sahasra247/RISCVMamba/docs/README.md

# docs/

Project documentation, interface specifications, reports, and architecture diagrams.  
**Owner:** E (Documentation & Coordination).

## Files in this Directory

| File | Purpose |
| --- | --- |
| `cfu_handshake_summary.md` | CPU-to-CFU interface handshake timing, pinout descriptions, stall behavior, and multi-cycle execution patterns. |
| `run_token_plan.pdf` | Architectural design report and bring-up plan for the single-token recurrent pipeline on CFU Playground. |
