sahasra247/RISCVMamba/results/spike_instr_counts_d256_l4.csv

kernel | baseline | +MAC | +MAC+NL | Xmamba
embed | 1813 | 1813 | 1813 | 1813
rmsnorm | 38007 | 38007 | 38007 | 38007
in_proj | 5141005 | 1655293 | 1655293 | 1655293
conv1d+silu | 192692 | 192692 | 100456 | 100456
x_proj | 547914 | 223802 | 223802 | 223802
dt_proj | 243774 | 88817 | 88817 | 88817
softplus | 327768 | 327768 | 14384 | 14384
scan | 3991110 | 3991110 | 1626336 | 16980
gate silu(z) | 105584 | 105584 | 32820 | 32820
out_proj | 2600445 | 871917 | 871917 | 871917
residual | 12332 | 12332 | 12332 | 12332
final norm+head | 337853 | 119993 | 119993 | 119993
total | 13541056 | 7629887 | 4786727 | 3177371
