sahasra247/RISCVMamba/hw/results/mamba_kernel_cycles.png

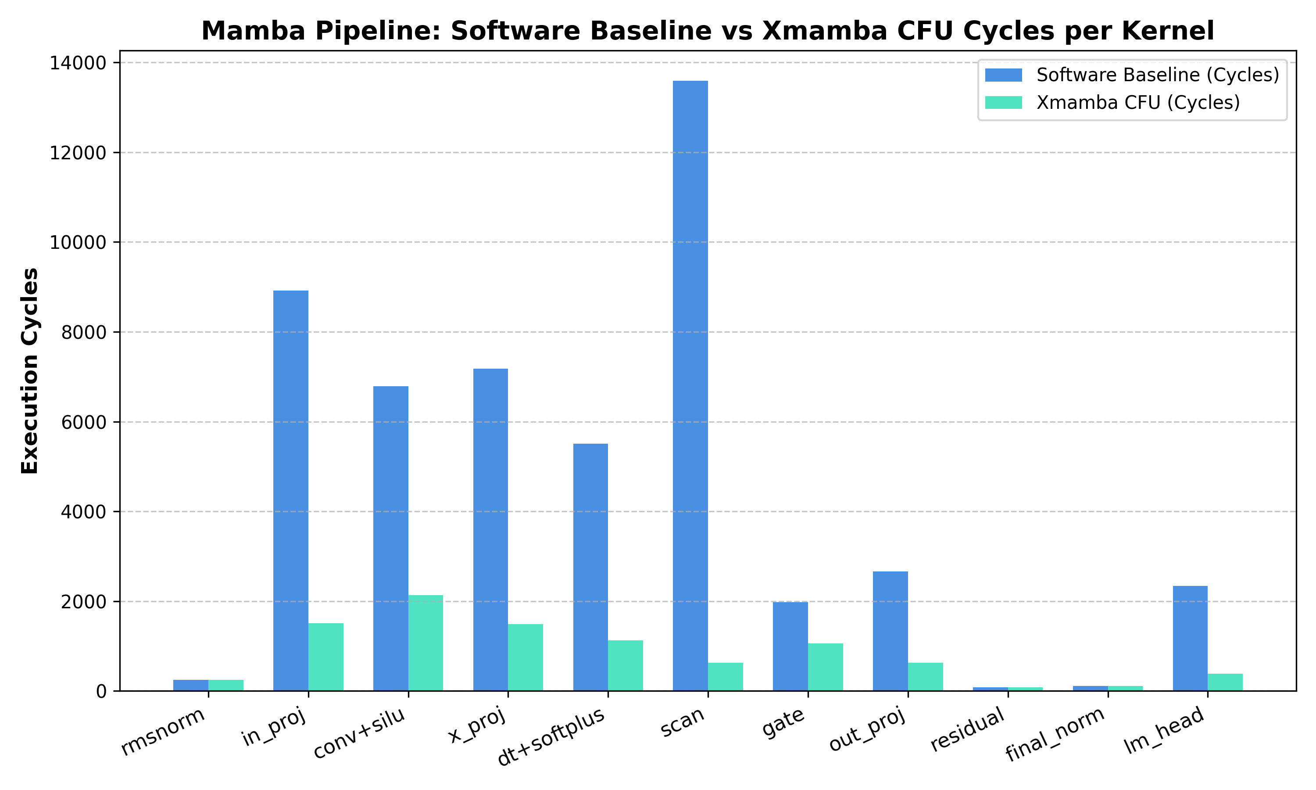
hw/results/mamba_kernel_cycles.png
