sahasra247/RISCVMamba/hw/results/mamba_kernel_speedup.png

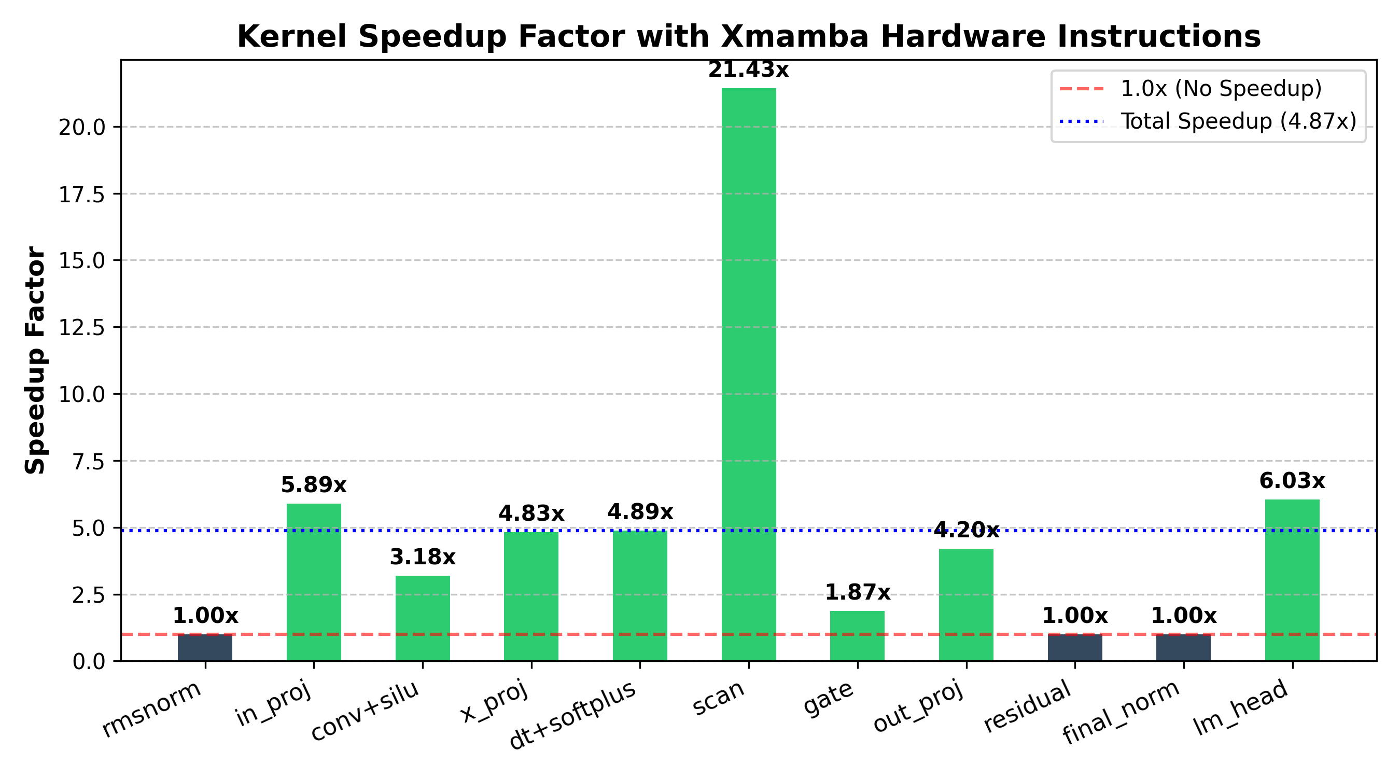
hw/results/mamba_kernel_speedup.png
