sahasra247/RISCVMamba/docs/run_token_plan.pdf

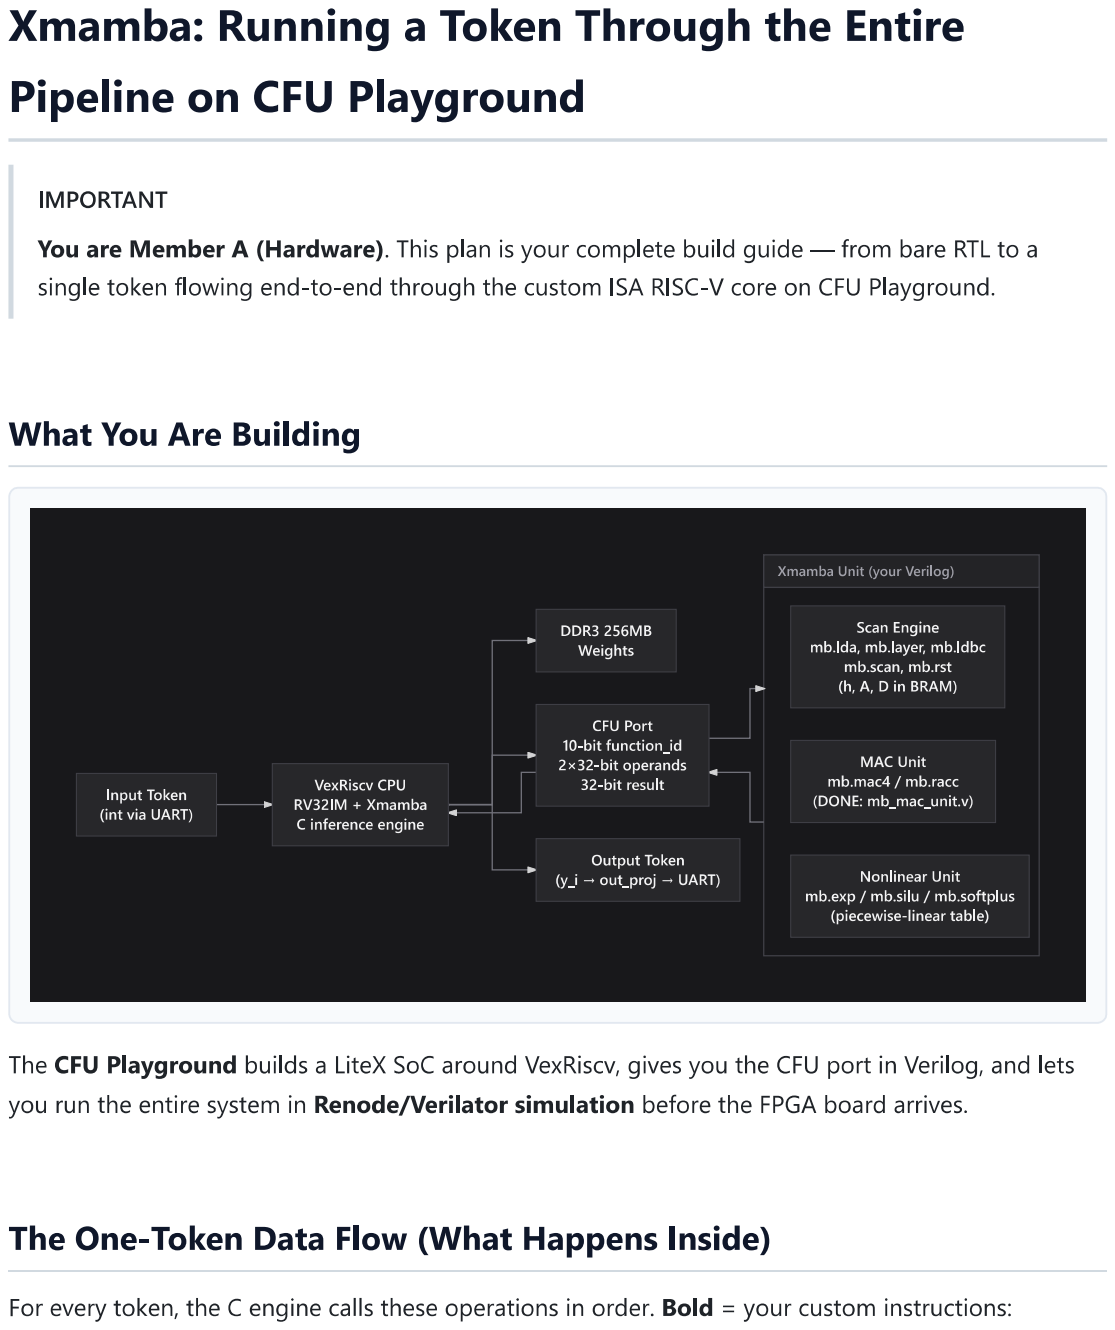
[picture p3: page 1]

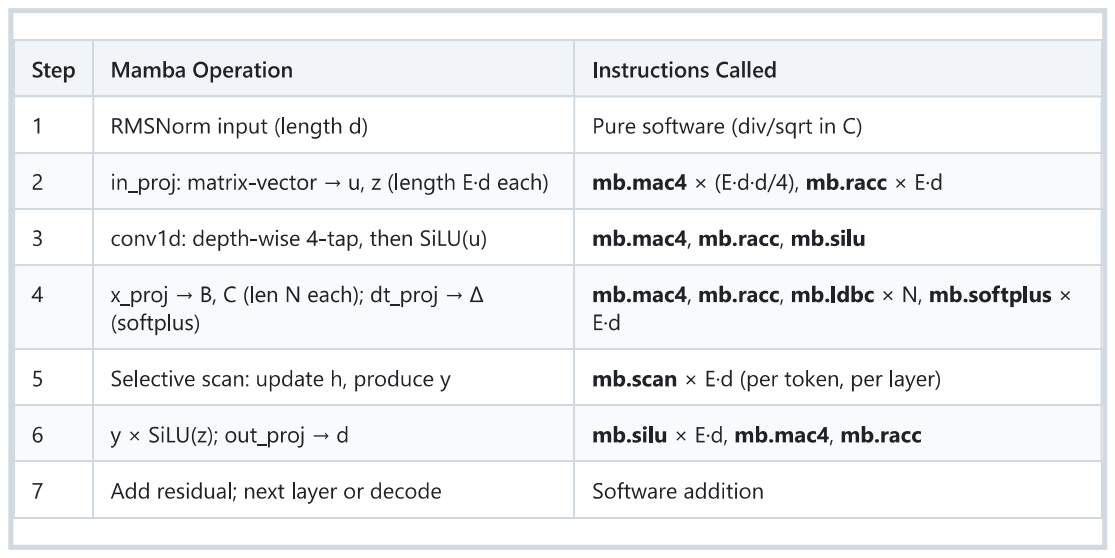
[picture p4: page 2]

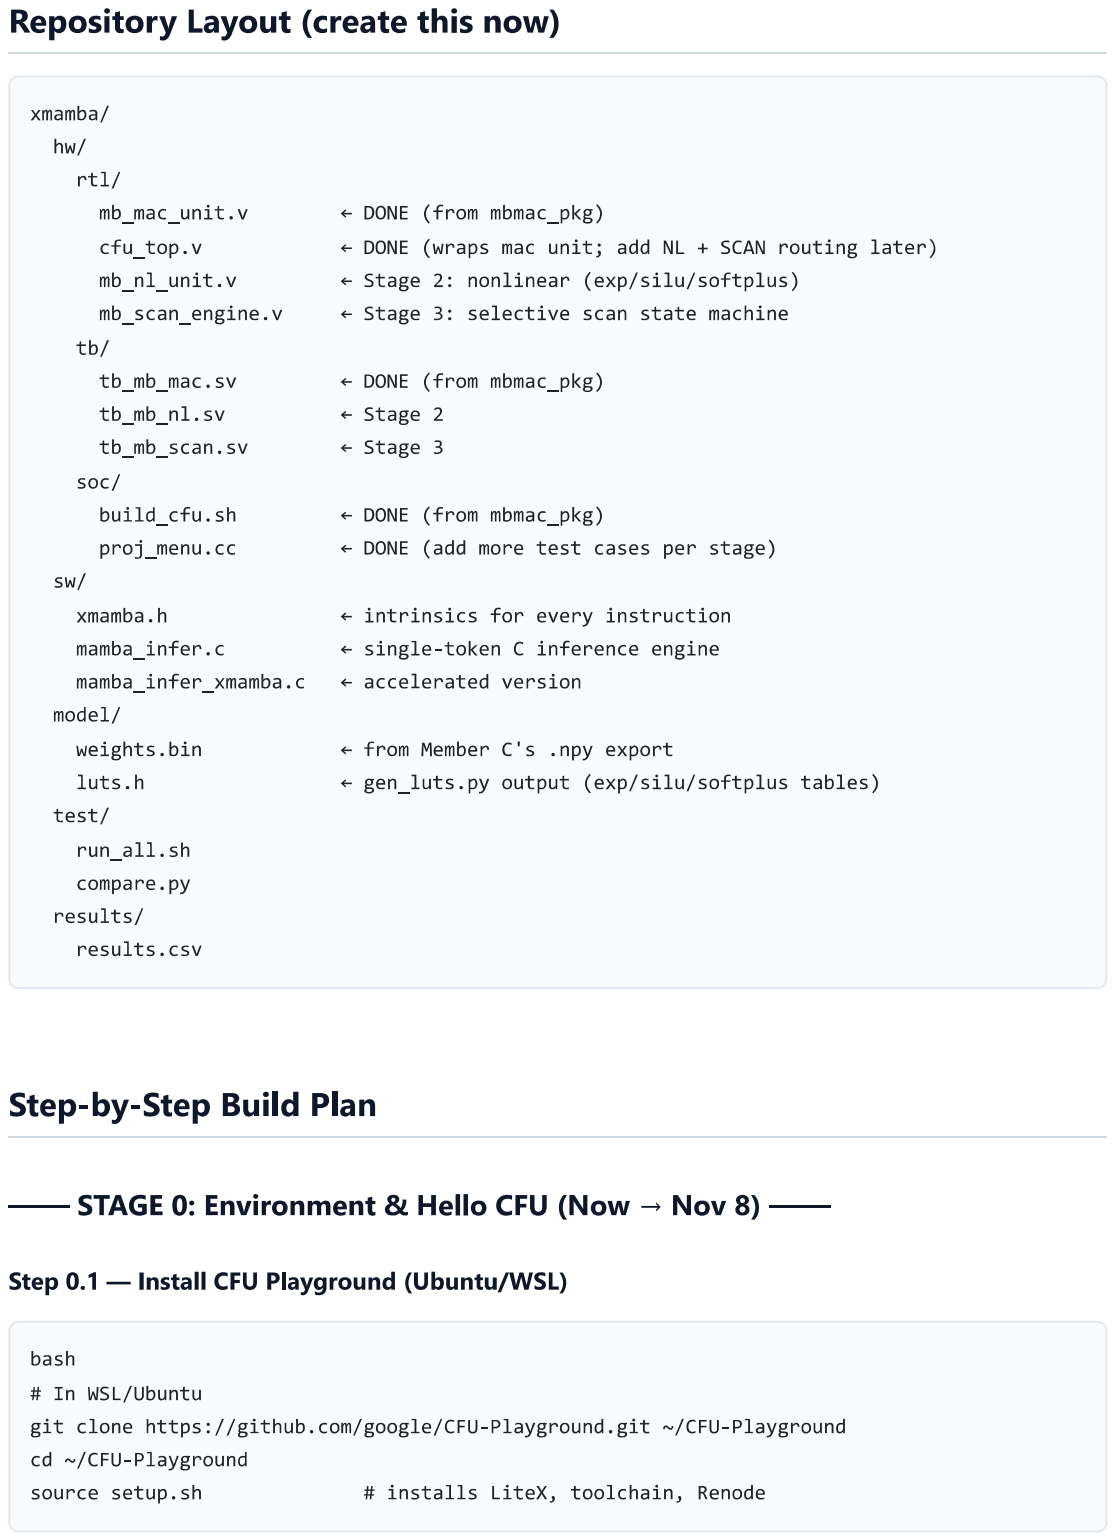
[picture p5: page 3]

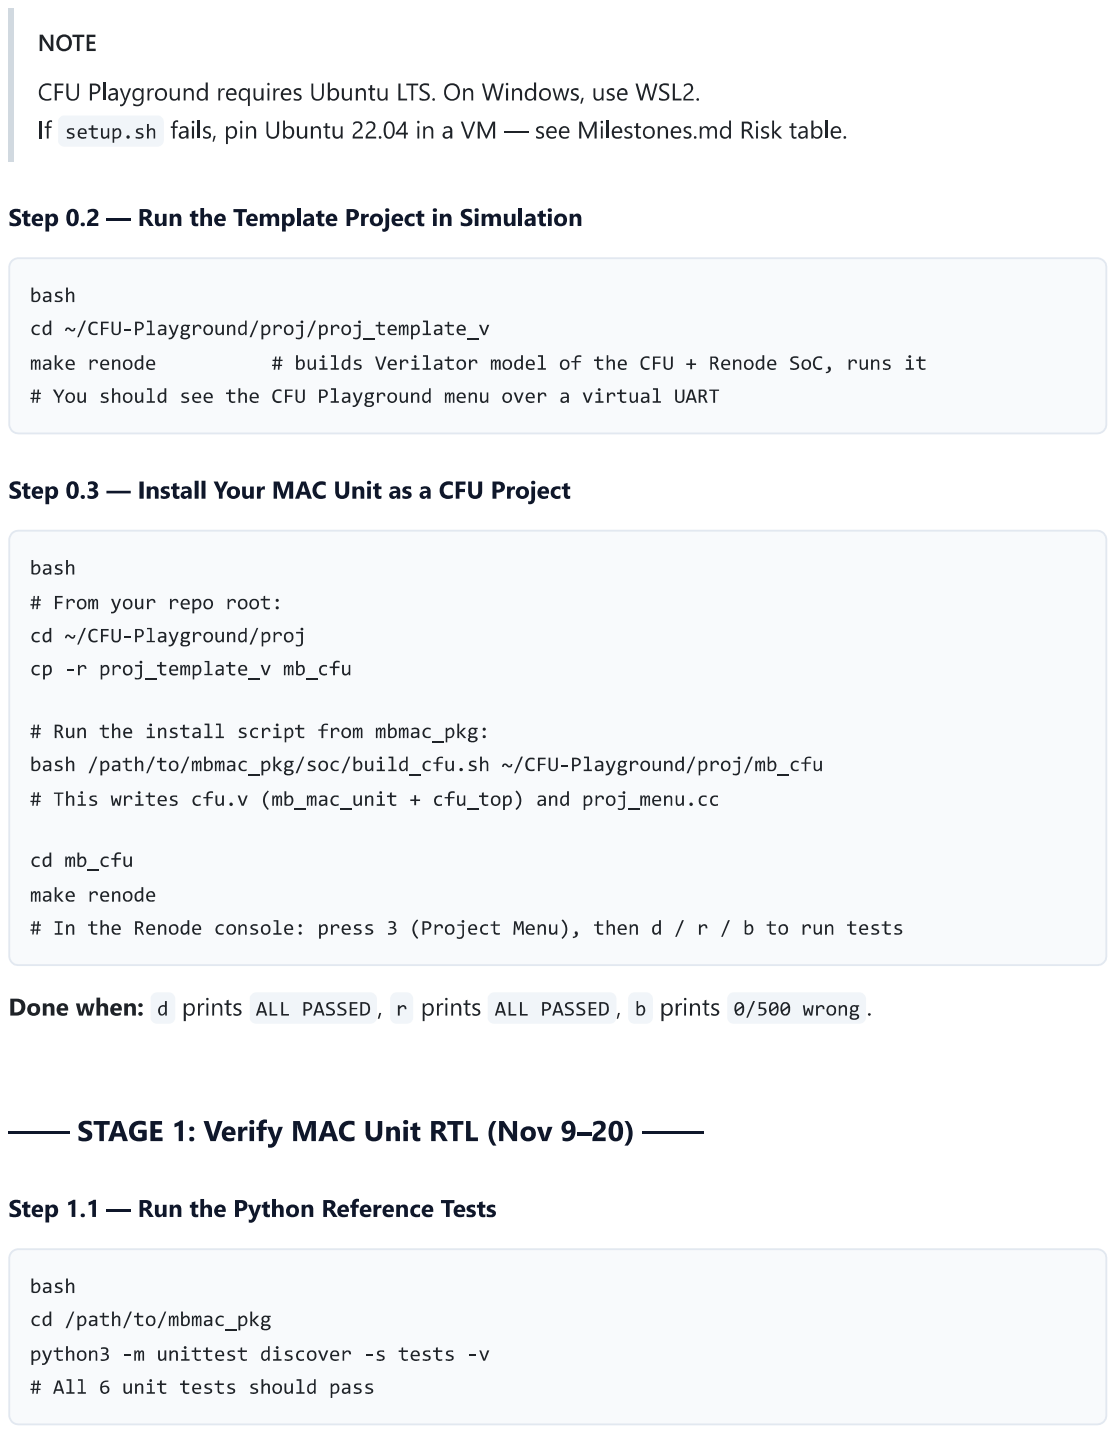
[picture p6: page 4]

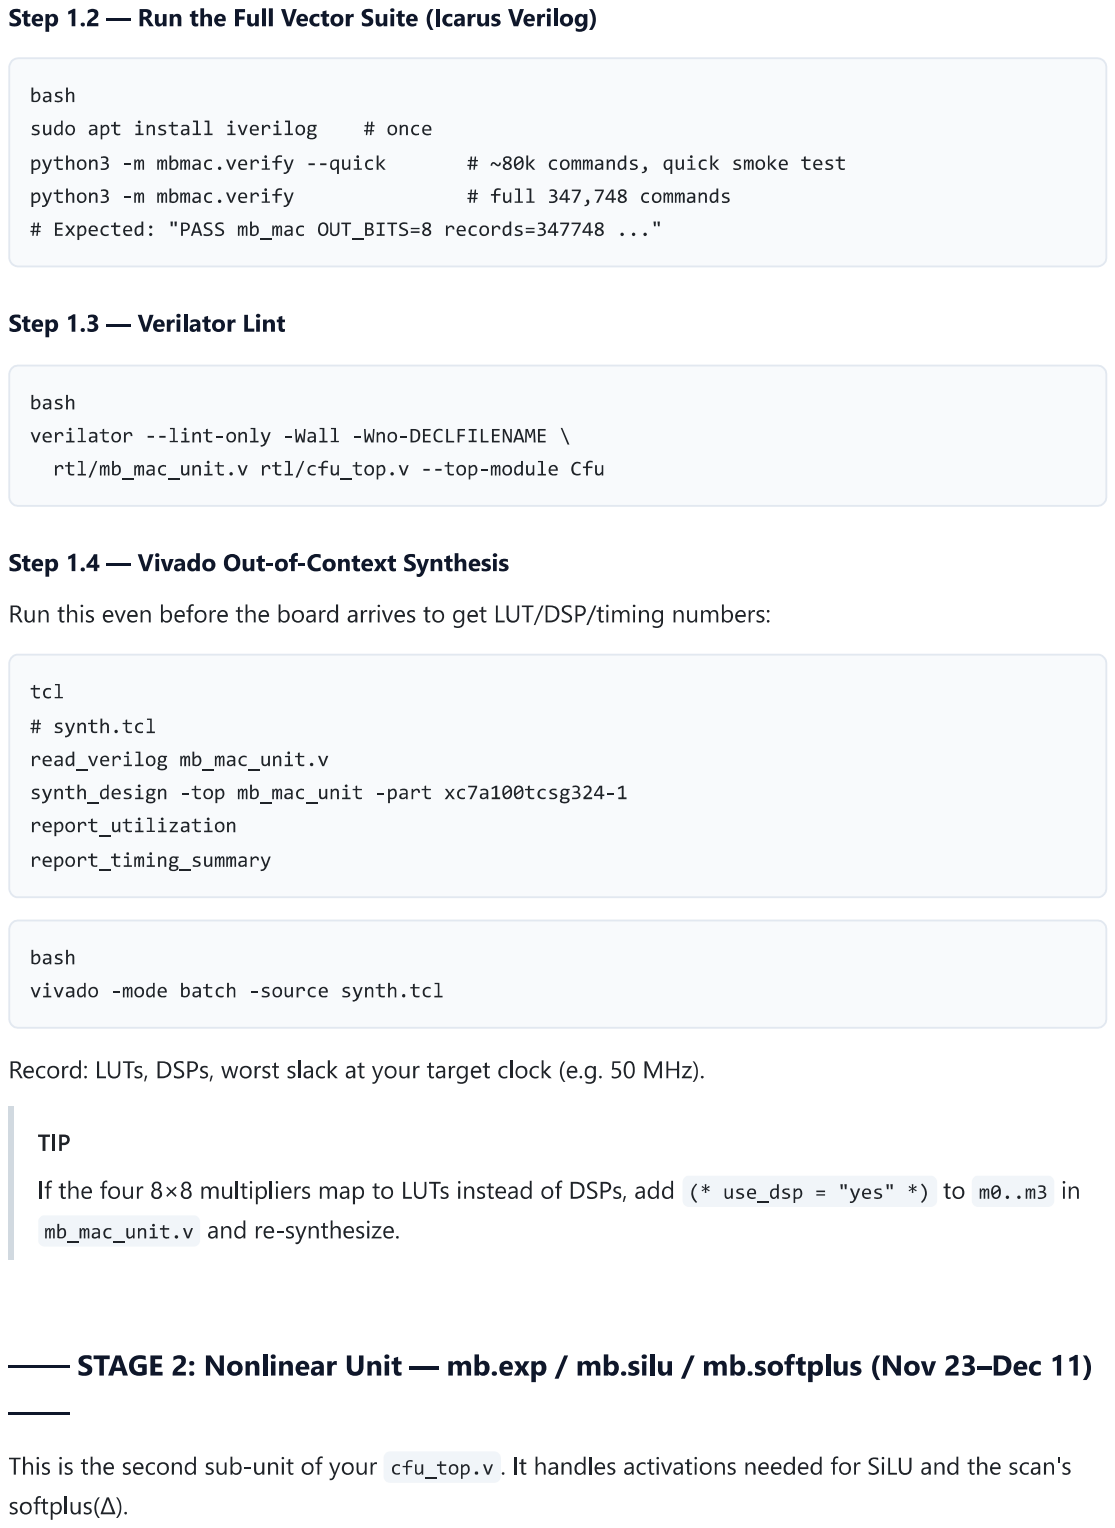
[picture p7: page 5]

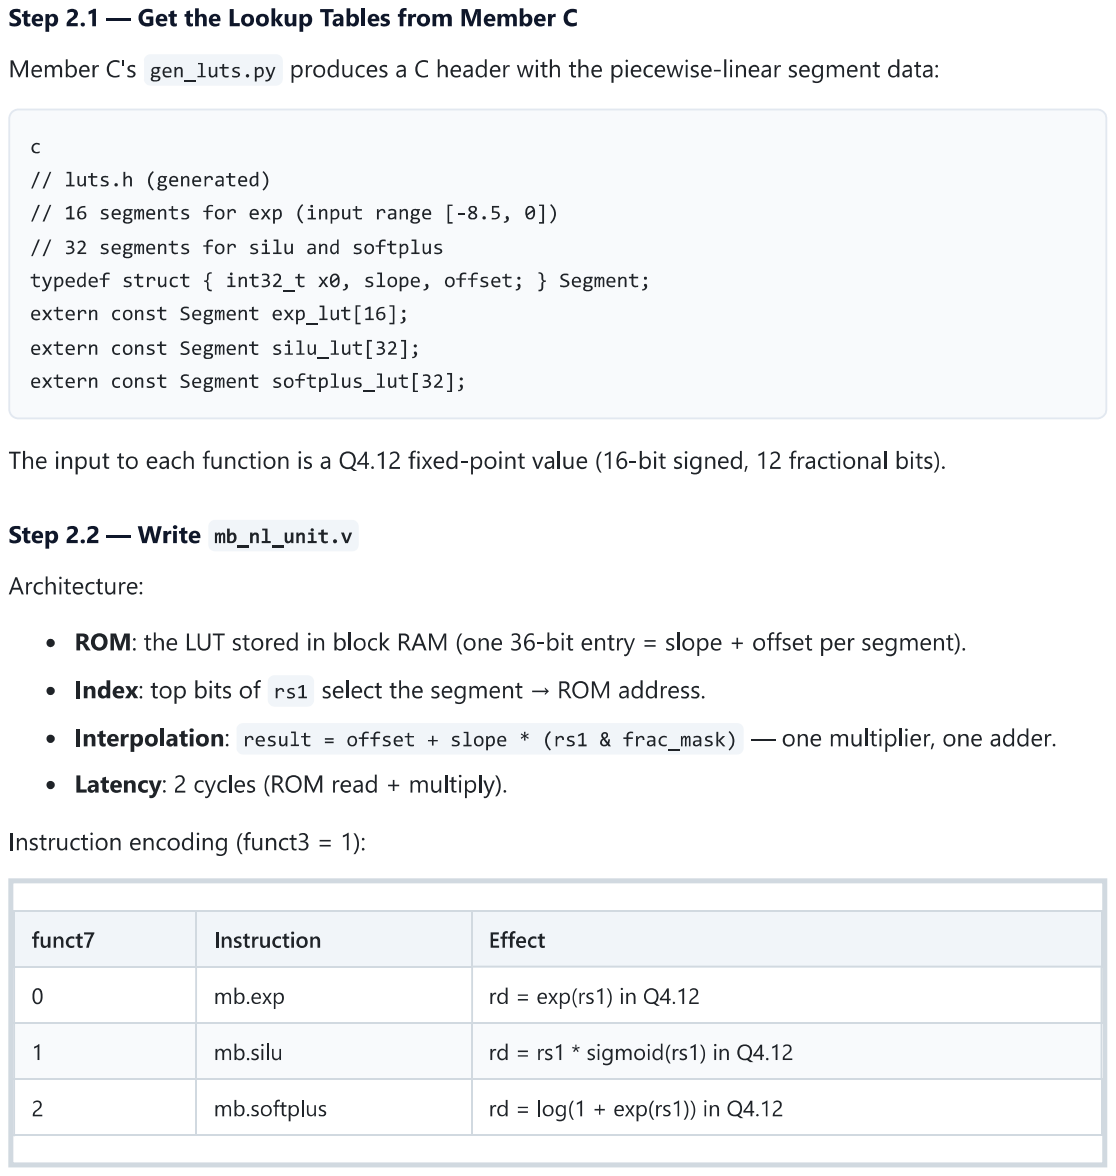
[picture p8: page 6]

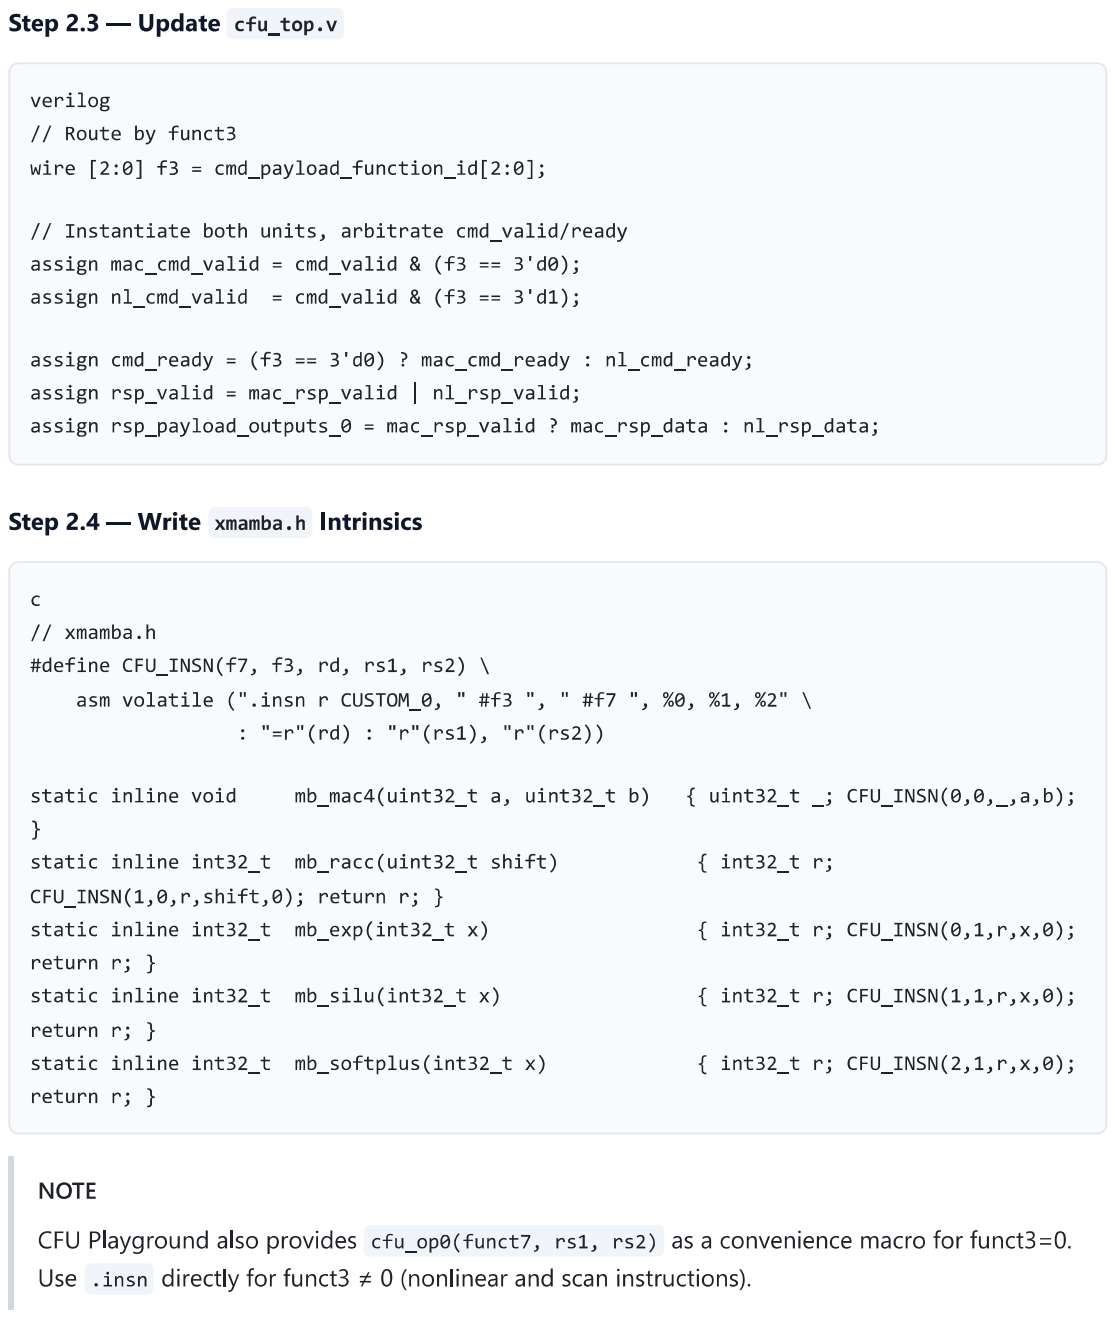
[picture p9: page 7]

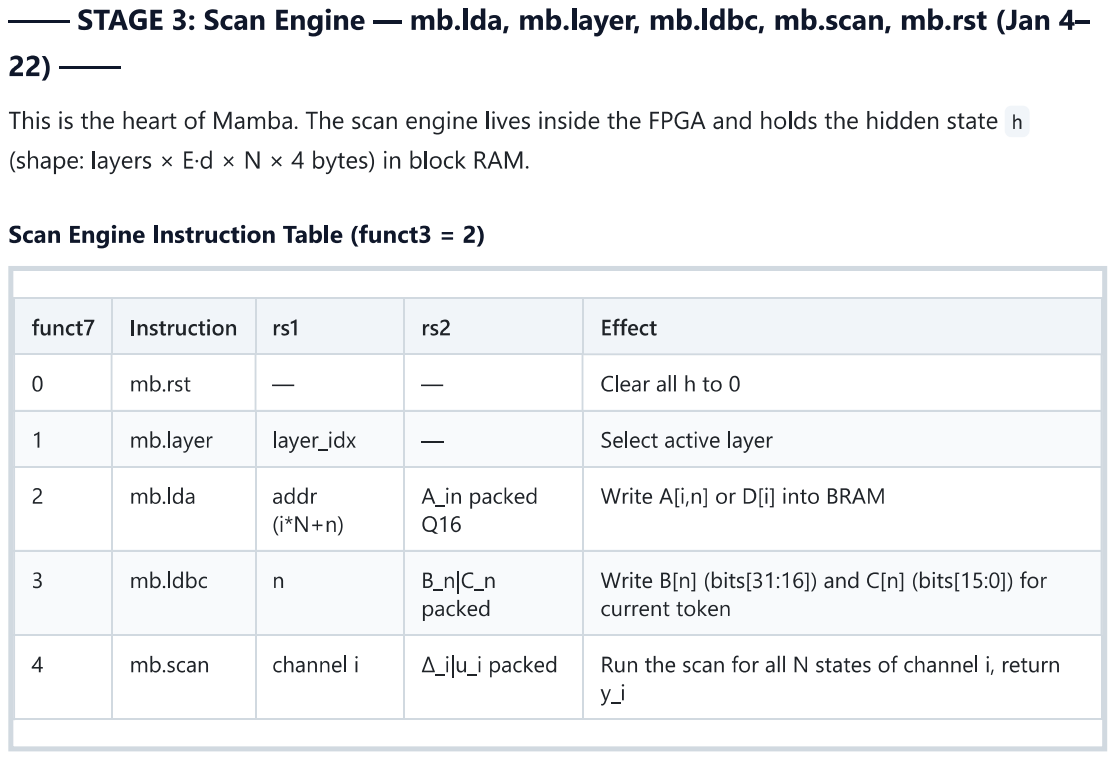
[picture p10: page 8]

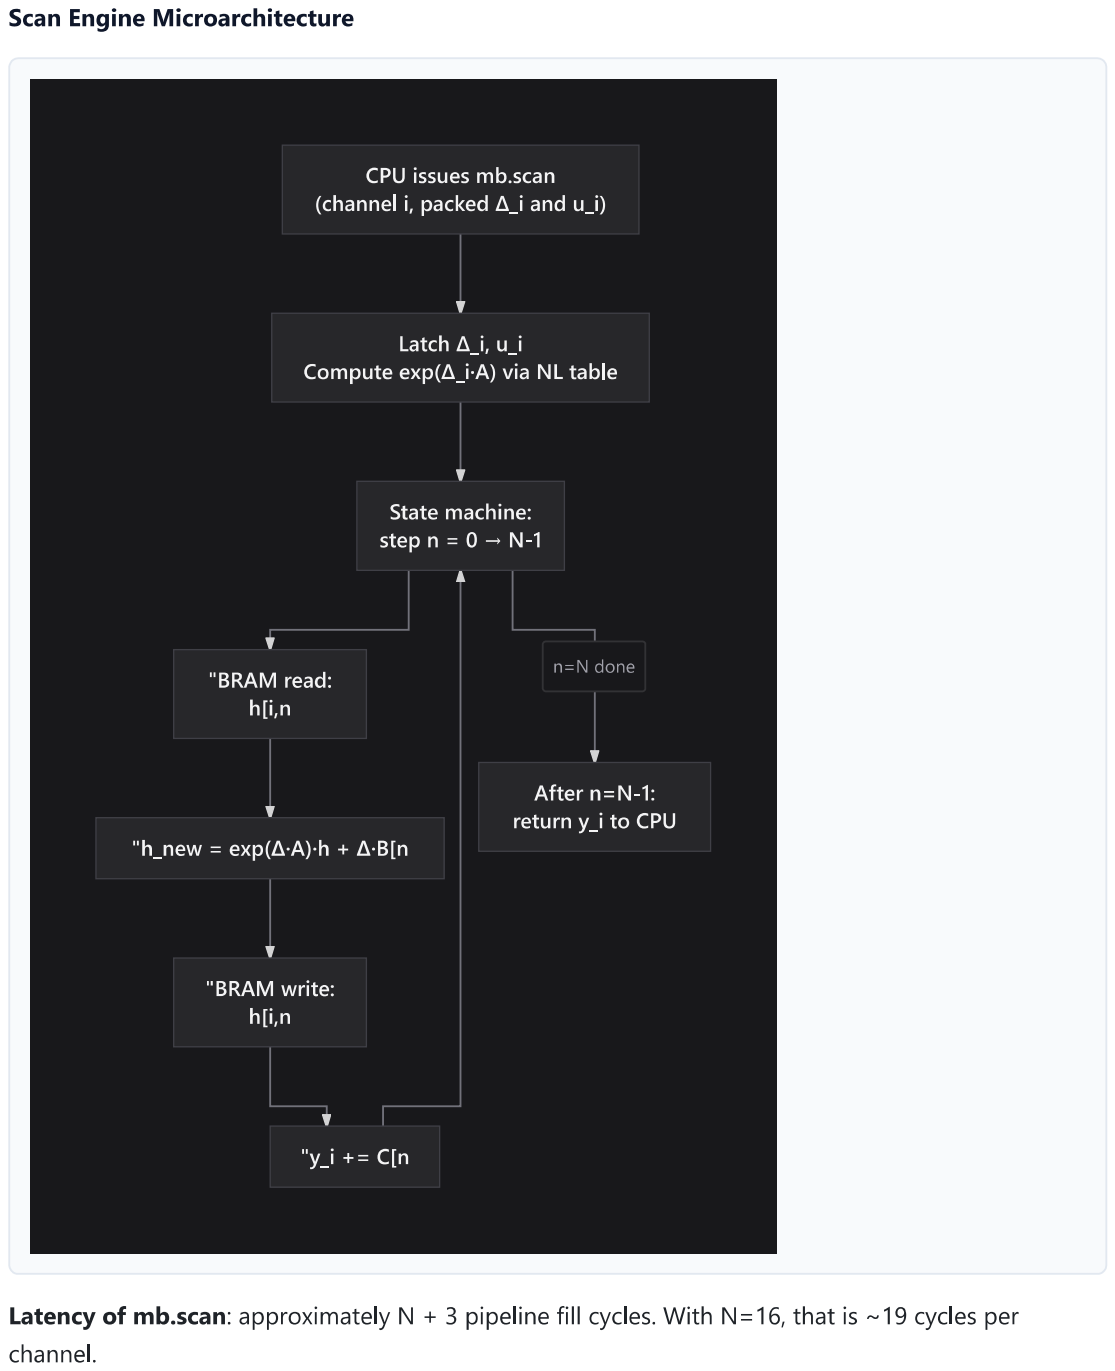
[picture p11: page 9]

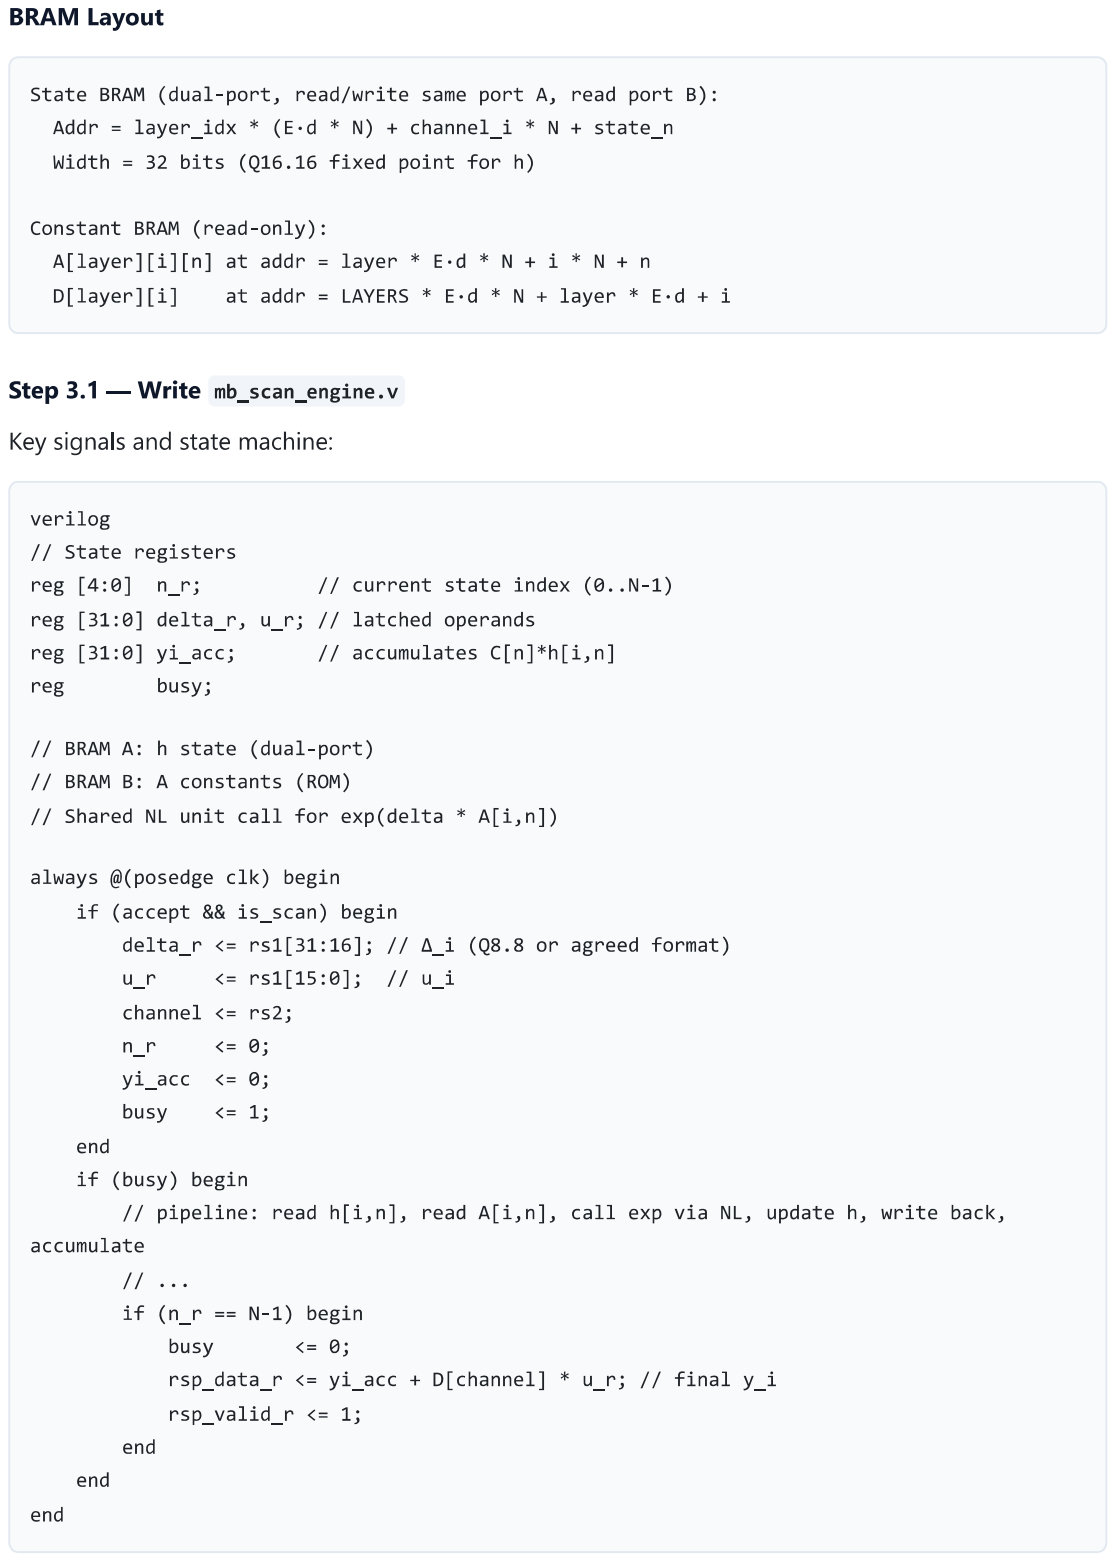
[picture p12: page 10]

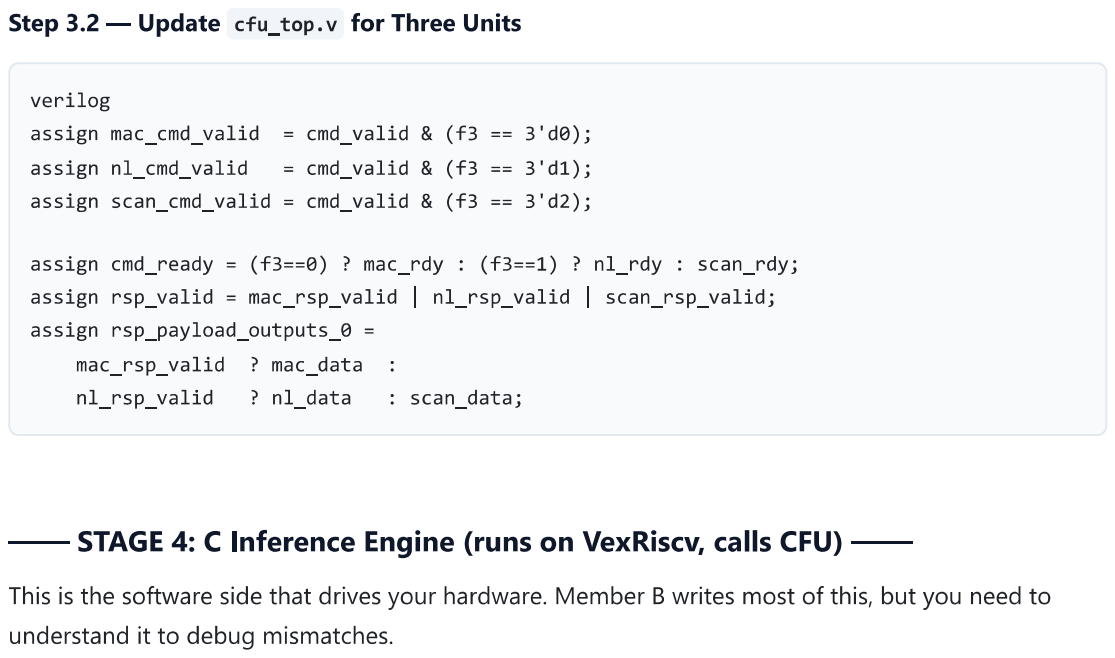
[picture p13: page 11]

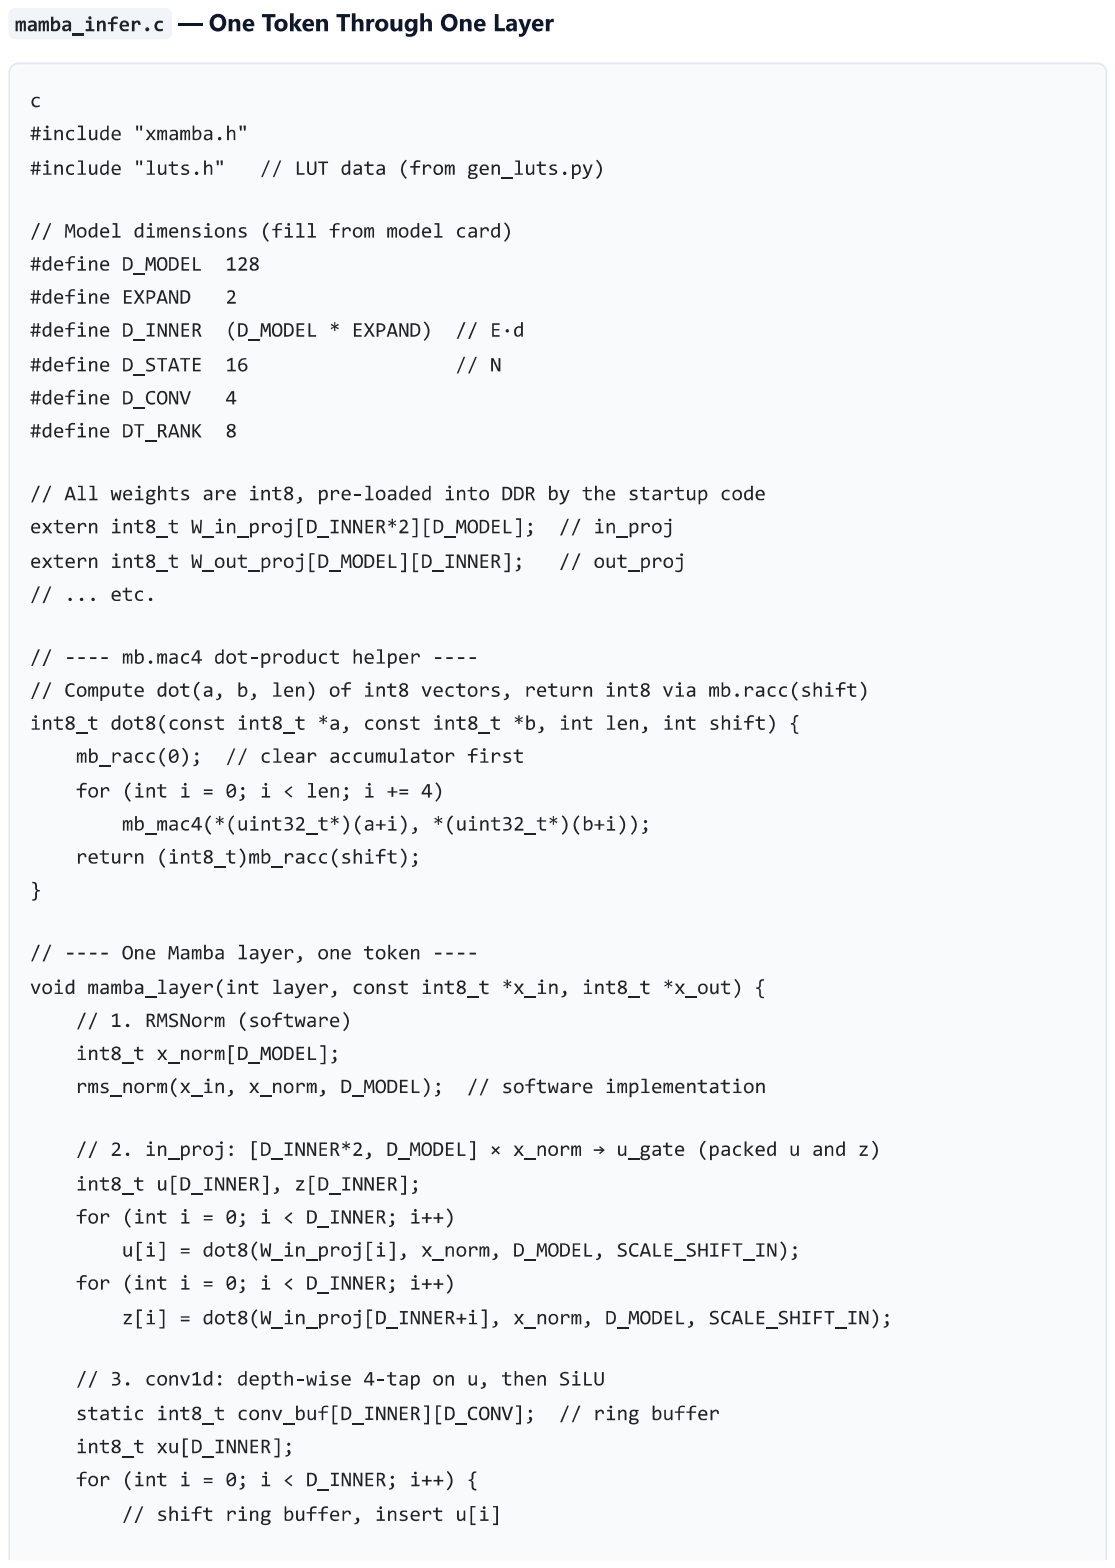
[picture p14: page 12]

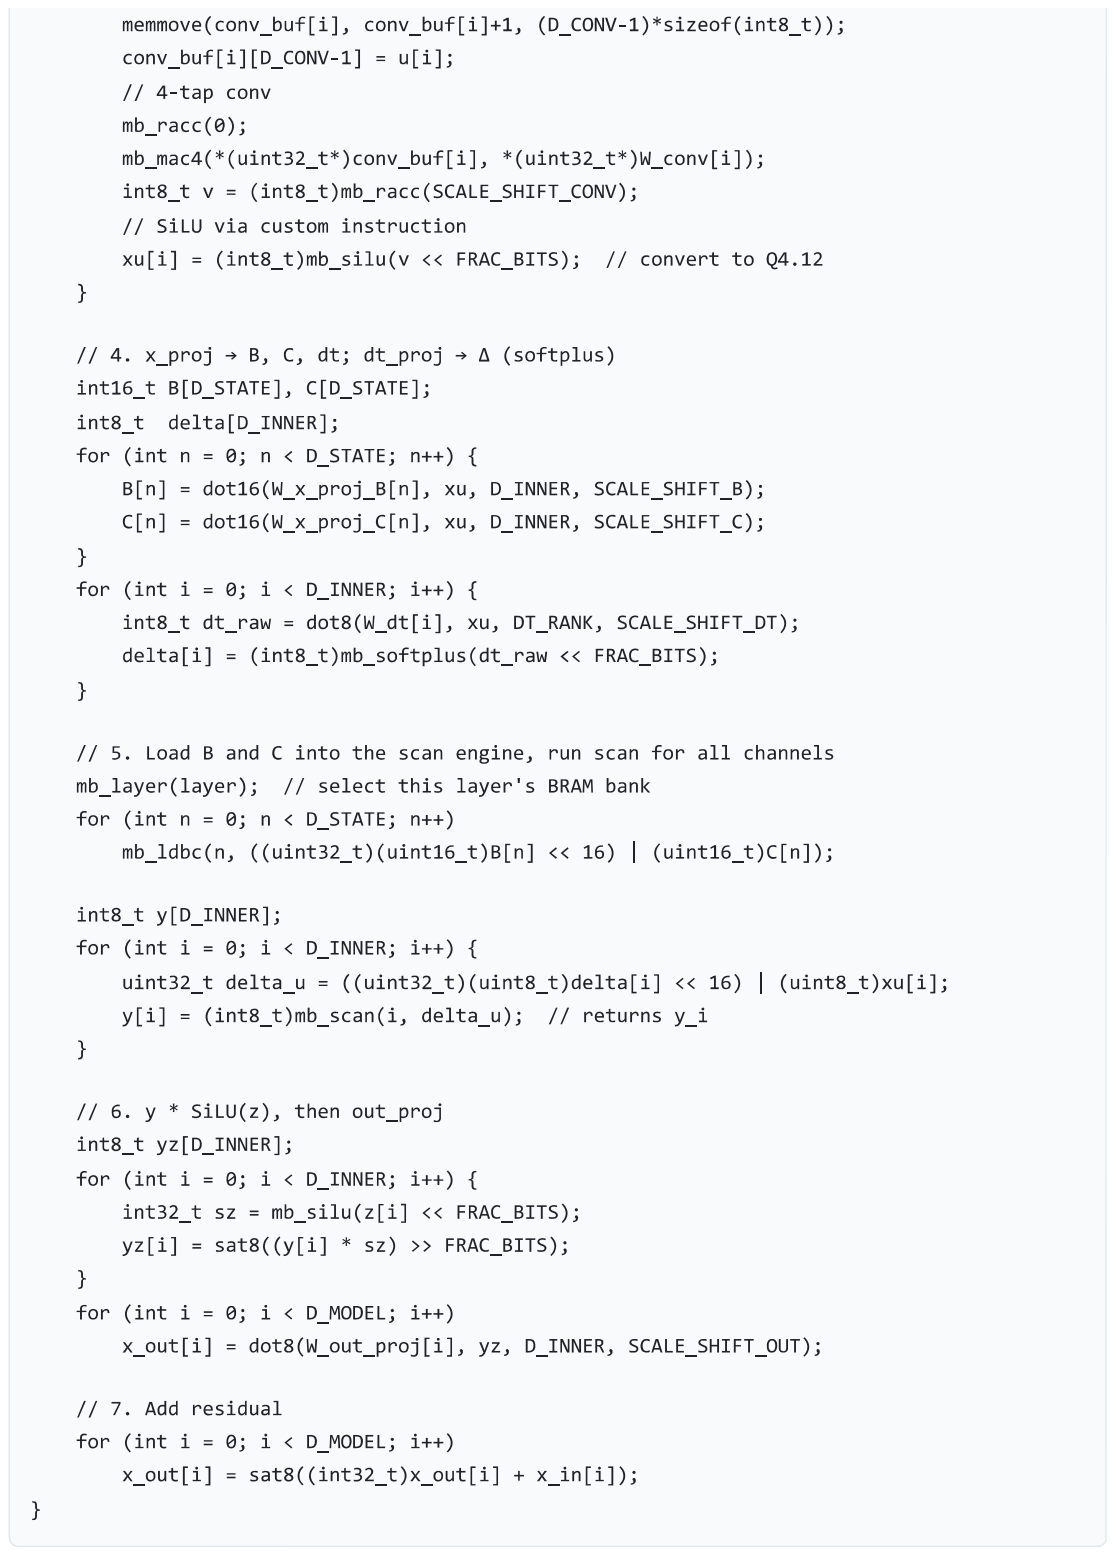
[picture p15: page 13]

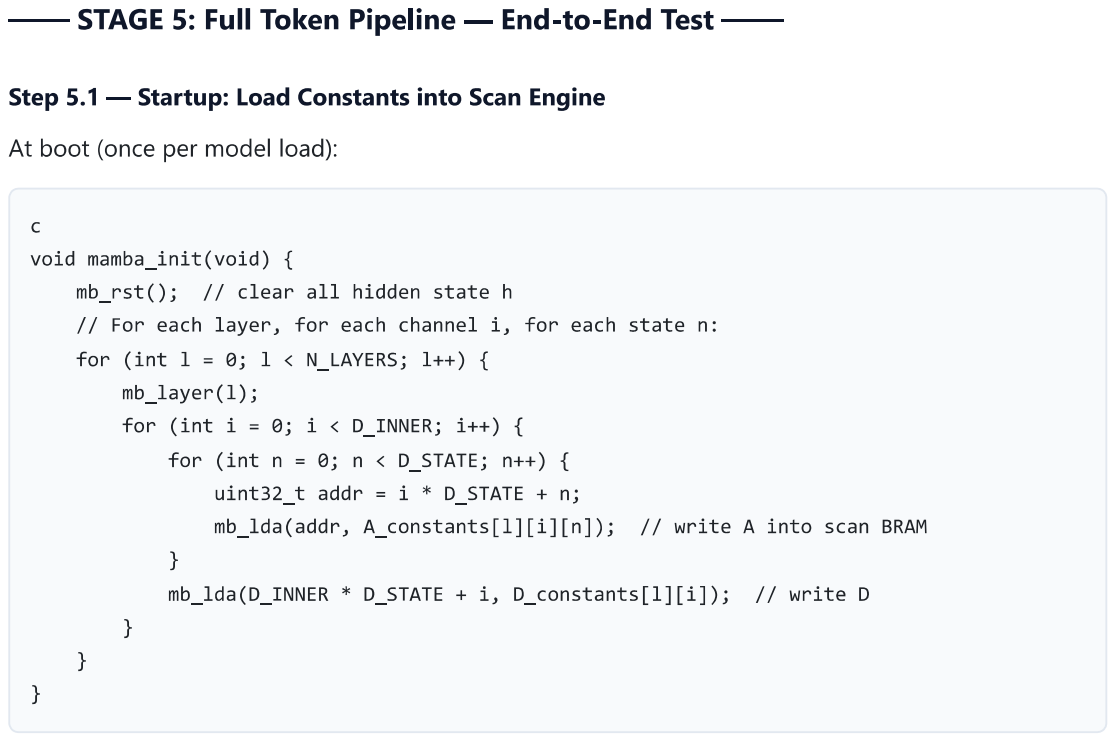
[picture p16: page 14]

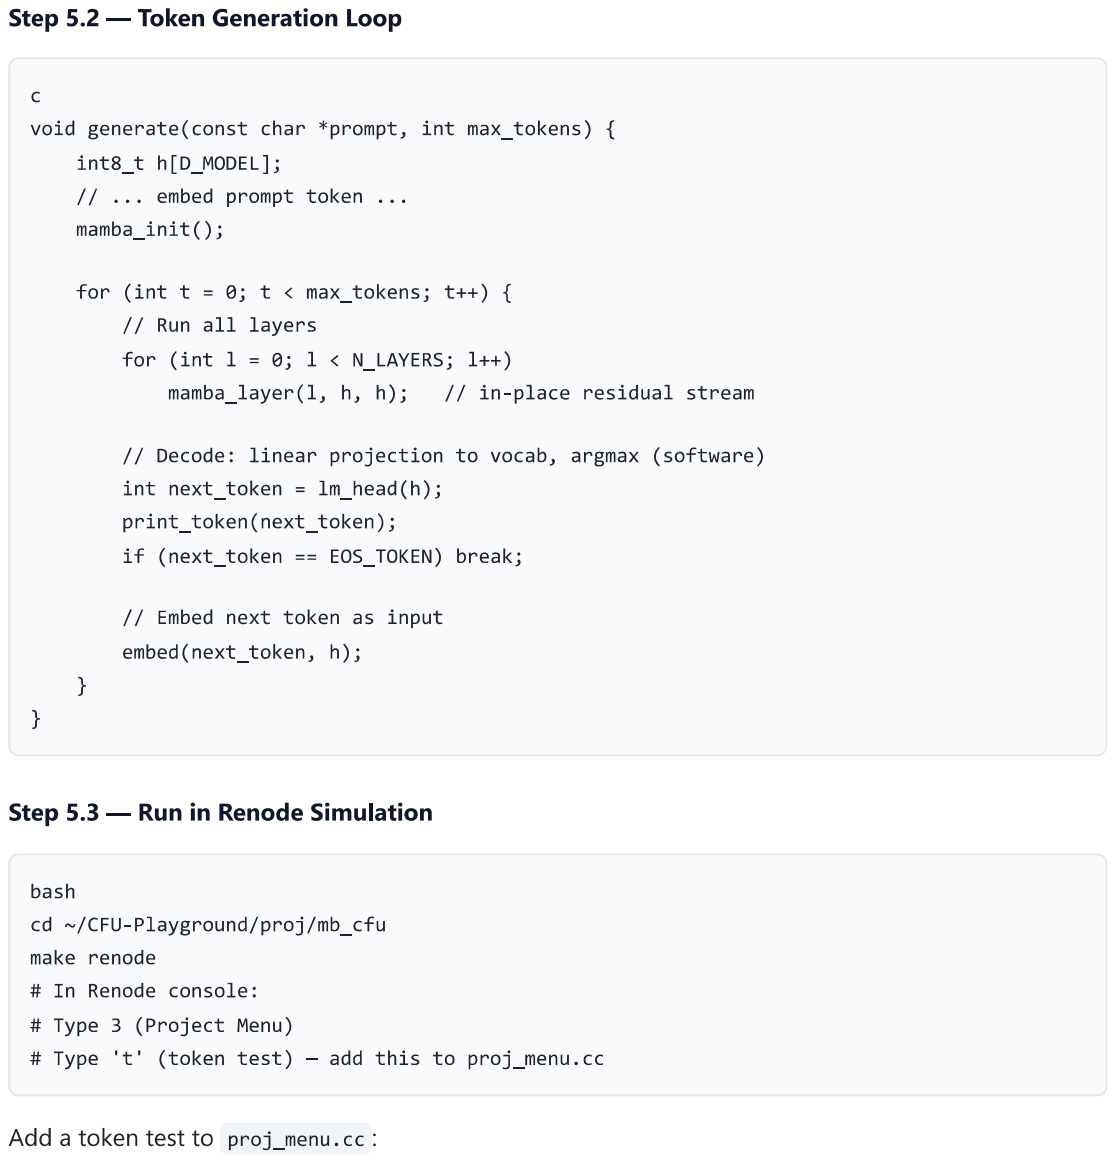
[picture p17: page 15]

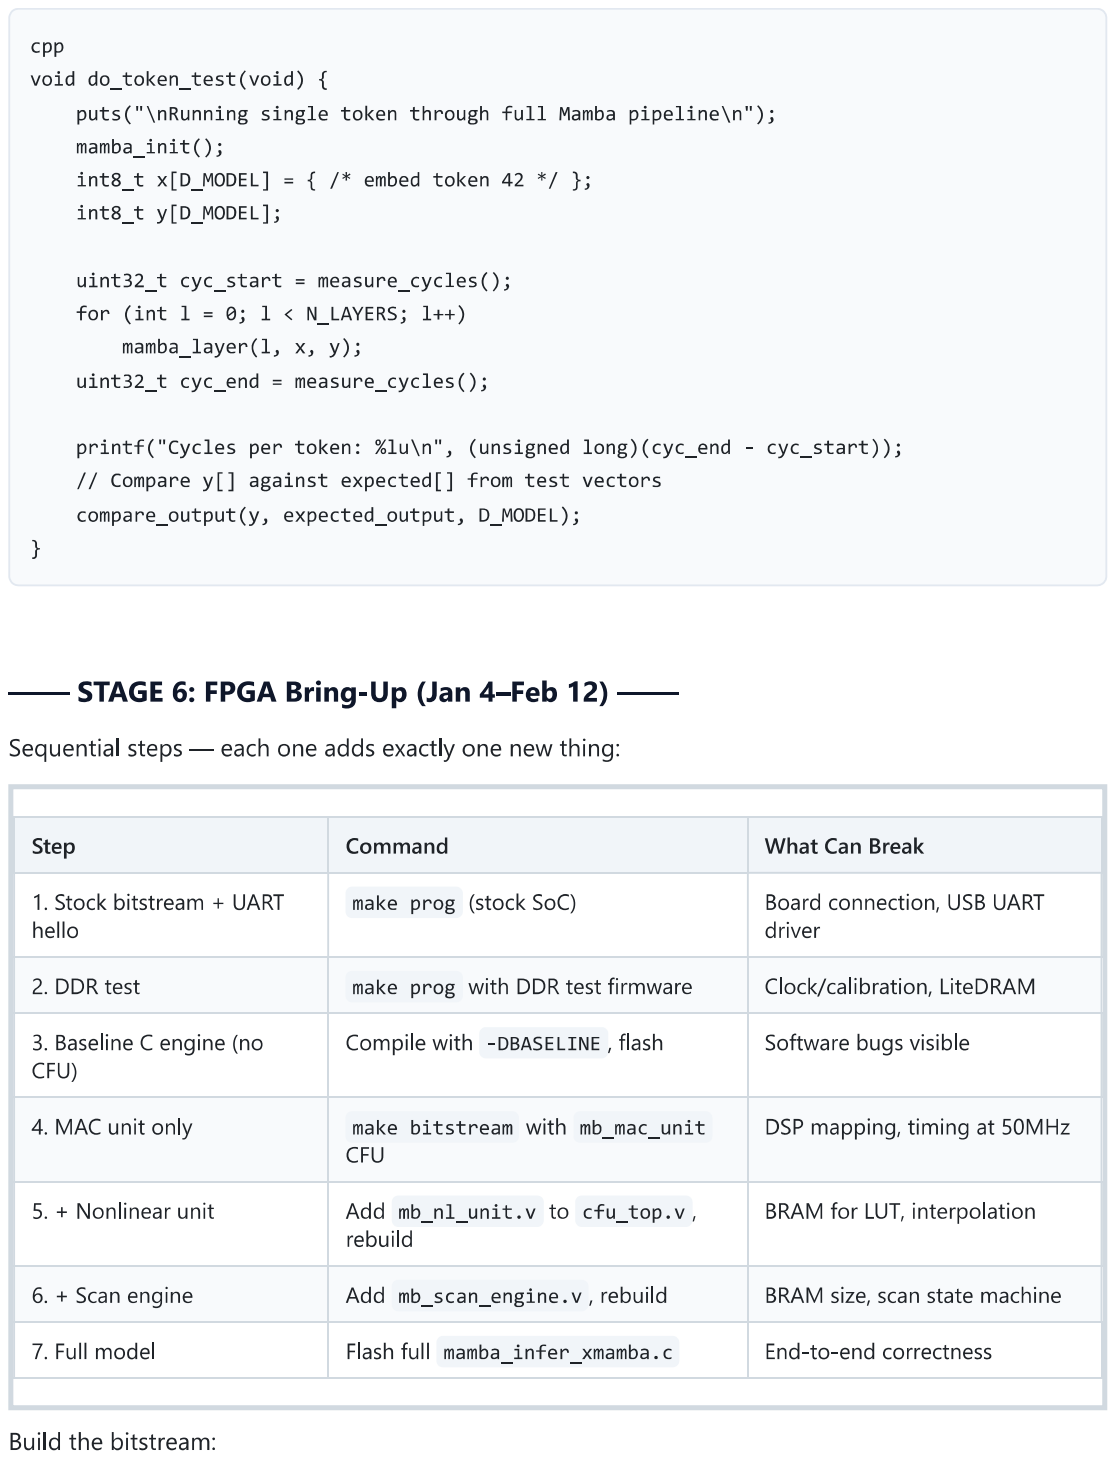
[picture p18: page 16]

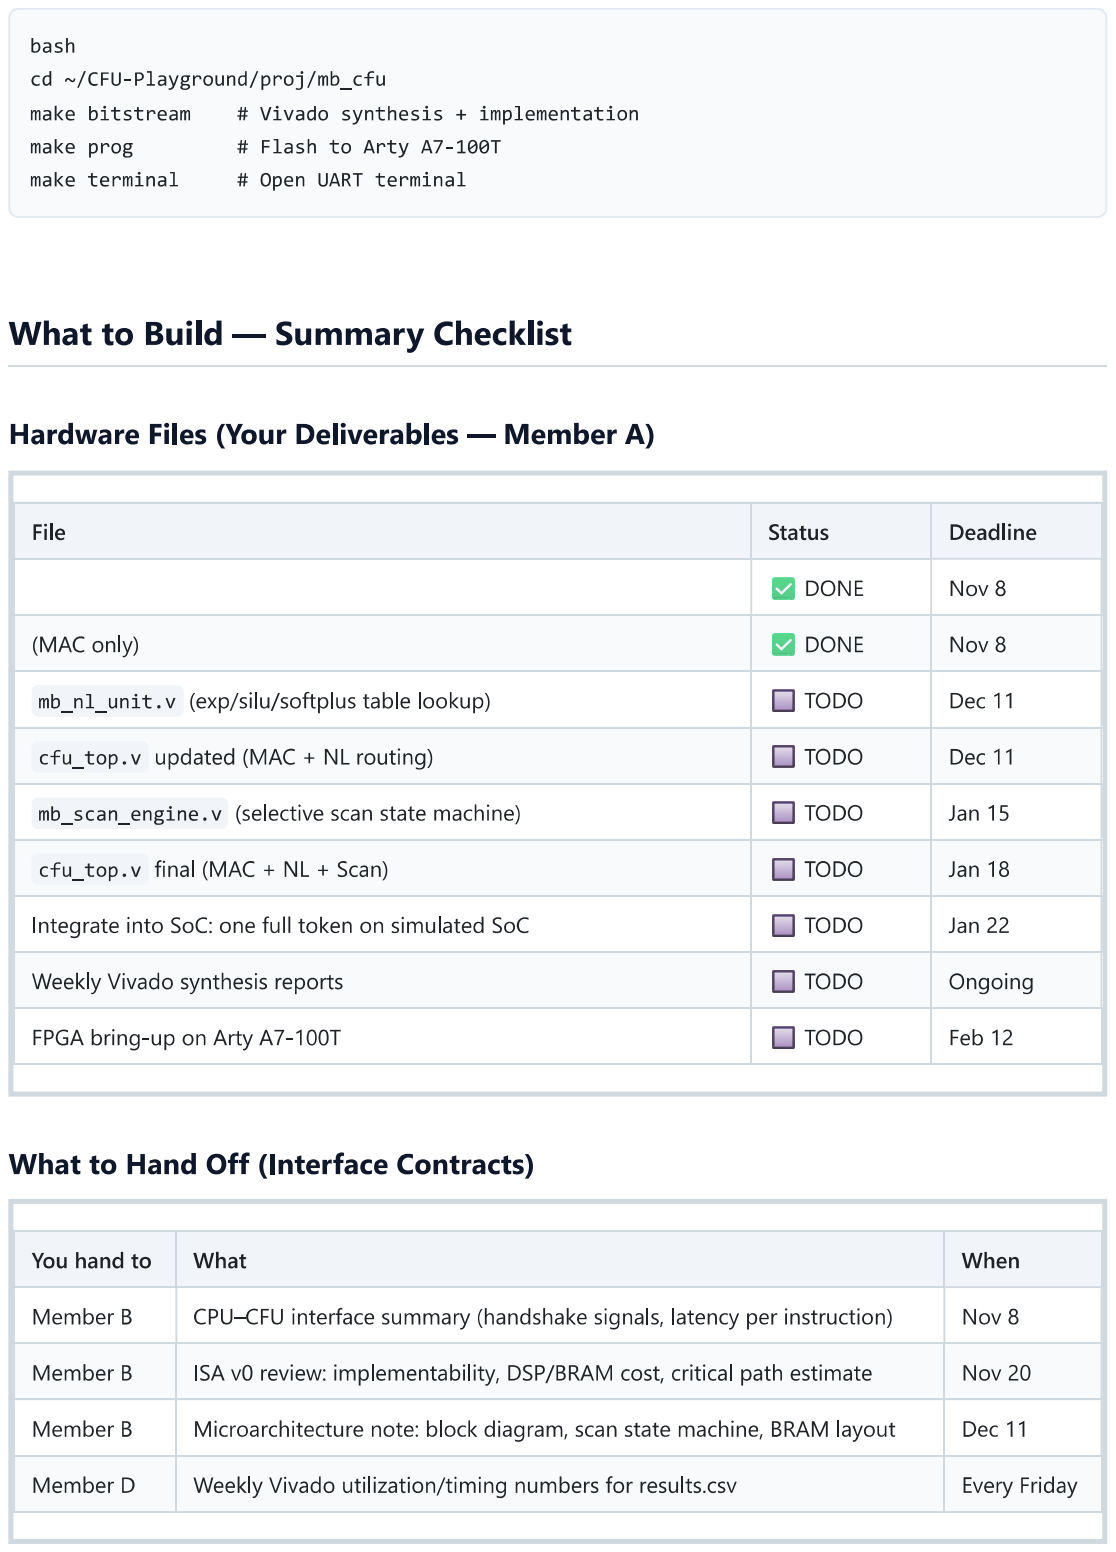
[picture p19: page 17]

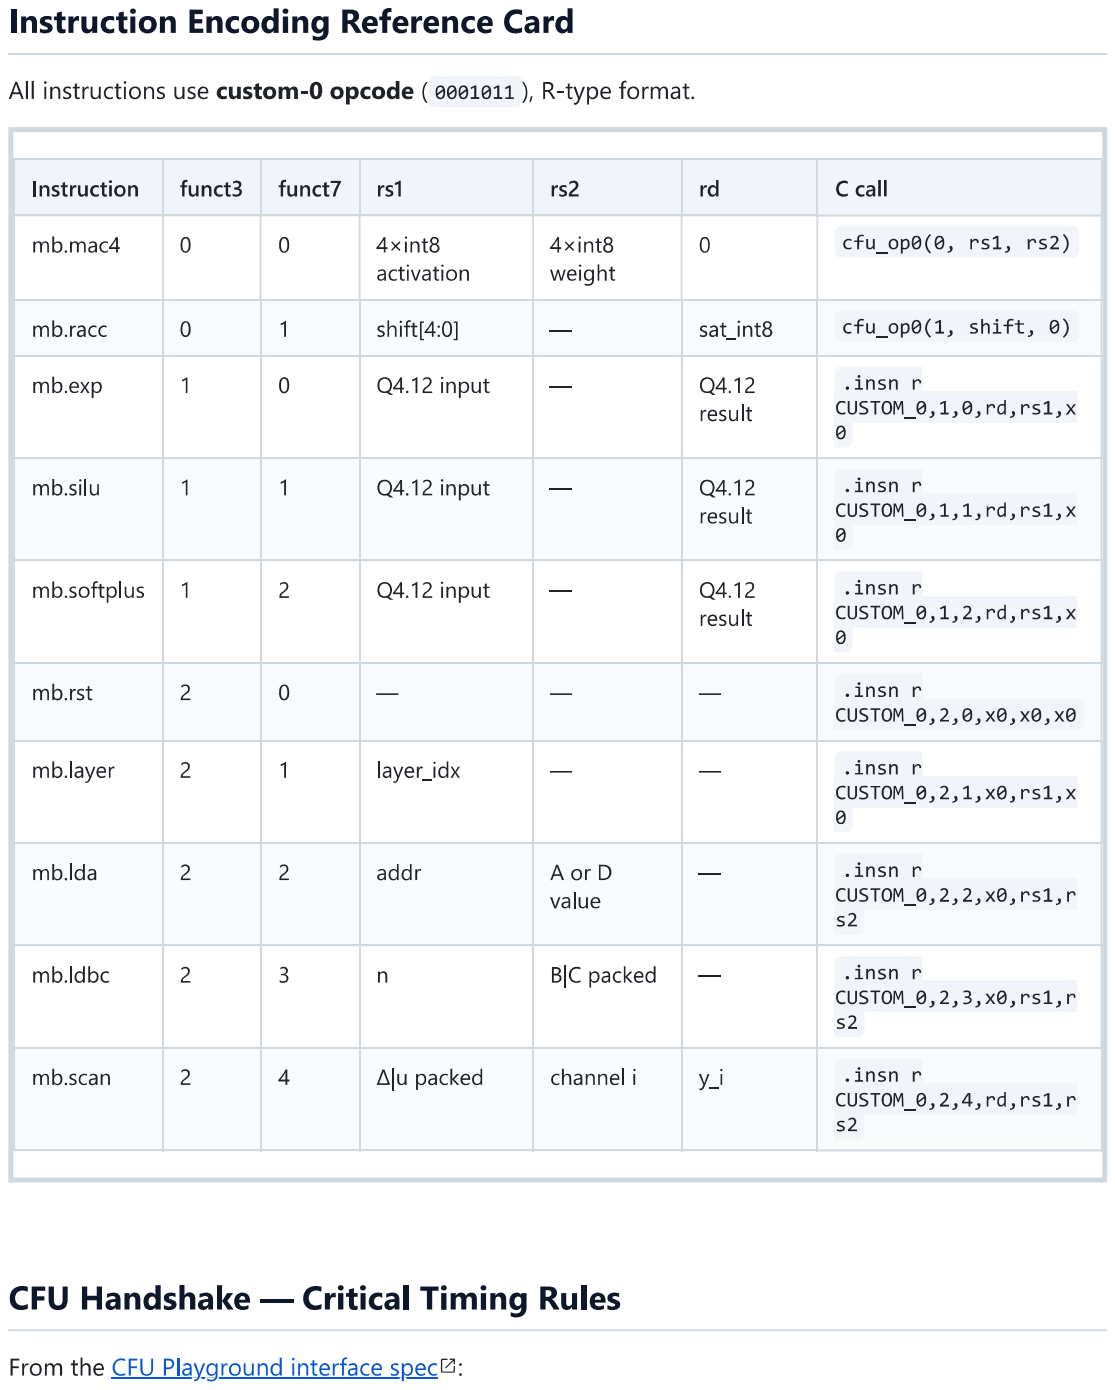
[picture p20: page 18]

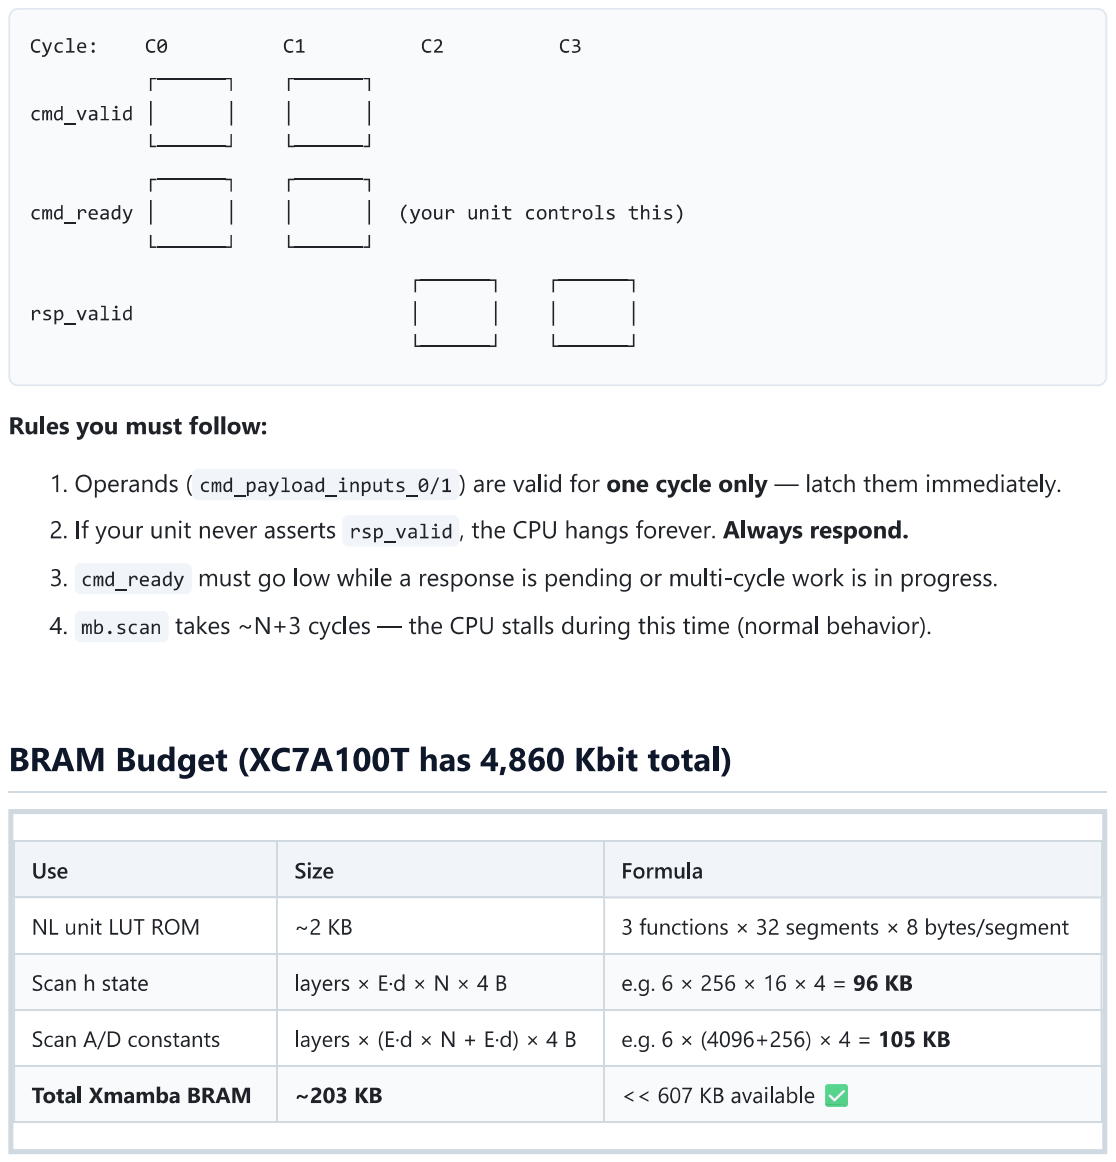
[picture p21: page 19]

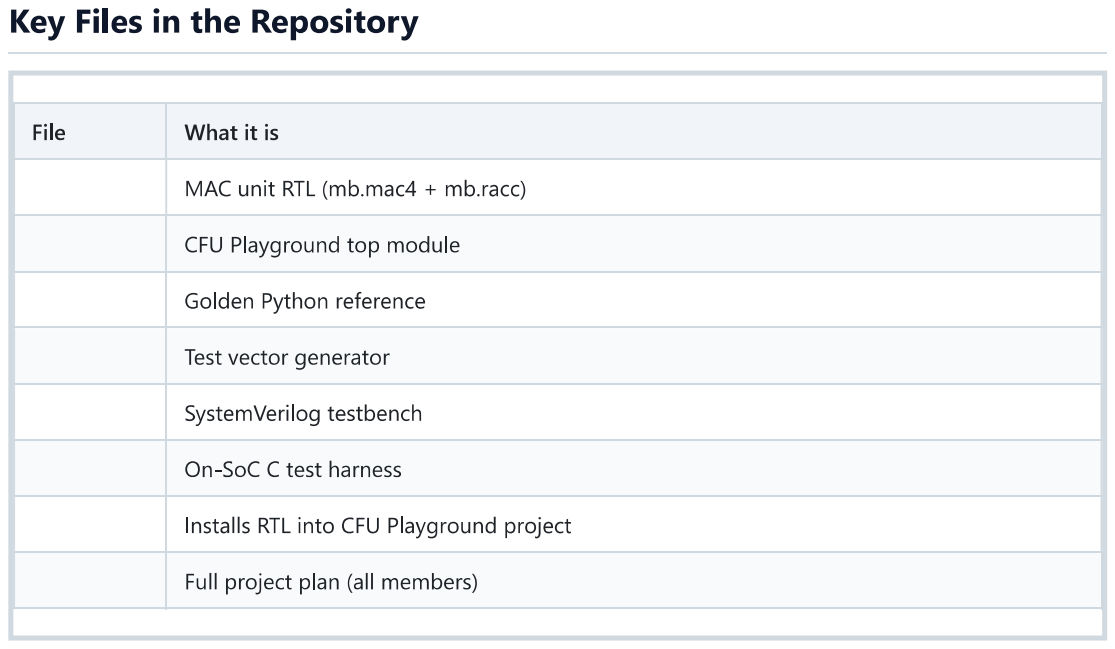
[picture p22: page 20]
