sahasra247/RISCVMamba/(commit log)

2026-11-03 Stage 0 (B): repo layout and bare-metal RV32IM runtime on Spike
    - Create the directory layout from "How we work" with owner READMEs.
    - Unpack the mb.mac4/mb.racc package into hw/mb_mac/ (replaces the zip and
    the duplicate root copy of mb_mac_unit.v; contents unchanged).
    - sw/: start-up code, linker script, HTIF console/exit (no pk needed),
    bm_printf, and 64-bit mcycle/minstret helpers with BM_PERF_BEGIN/END.
    - sw/tests: hello world and a counter test (overhead, 10x scaling check,
    int8 dot product at ~11.5 instructions per MAC). `make -C sw run` passes.
    - Tick B's Stage 0 tasks in Milestones.md.
    [cfu_top.v, counters.c, mb_mac_unit.v]
2026-11-03 updated cfu_playground
    updated cfu_playground with demo and single token test run and comparison with normal CPU implementation
    [results.csv]
2026-11-04 Stage 1 (B): NumPy one-token Mamba reference
    model/mamba_step.py: float golden model in recurrent step form with HF
    MambaForCausalLM weight names, random weights with mamba_ssm-style init,
    a per-stage trace for test vectors, and a self-check against an independent
    whole-sequence form (closed-form scan). Loading the real checkpoint and the
    PyTorch comparison are left as TODOs for Model & Reference.
2026-11-04 Stage 1 & 2 (B): Fixed-point engine, Spike Xmamba extension, and profiling
    [spike_instr_counts_d256_l4.csv]
2026-11-04 Add progress.md: comprehensive progress and status report for all stages and team members
2026-11-04 Little bit of repository cleanup
    [results.csv]
